joesilber/raft-design/illustrations/chamfered equilateral triangle coords.png

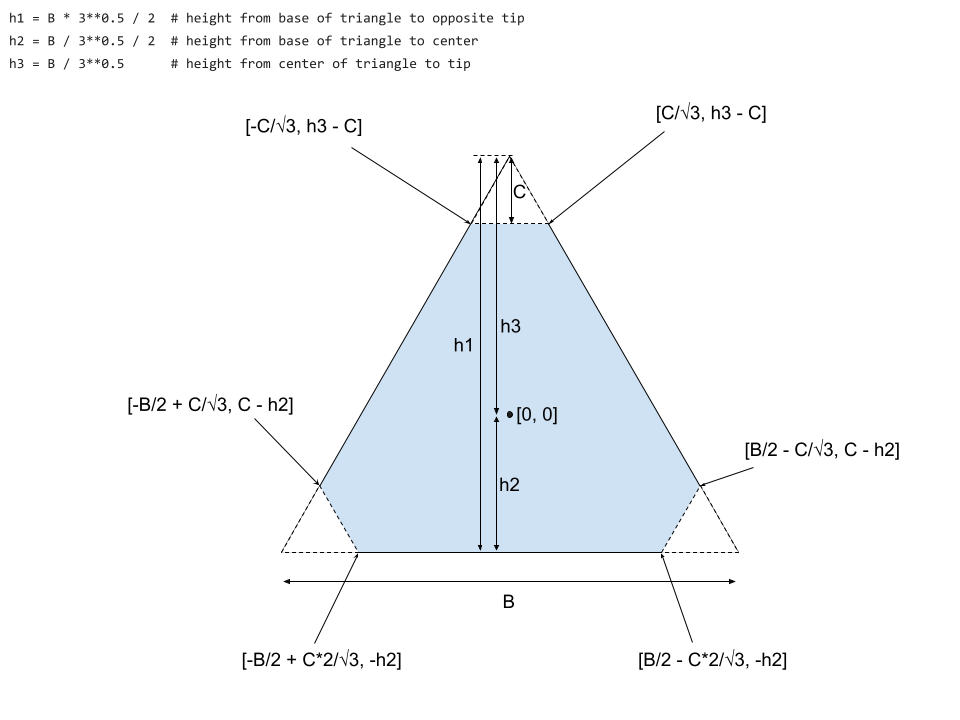
illustrations/chamfered equilateral triangle coords.png
