joesilber/raft-design/illustrations/echo22_chief_ray_deviation.png

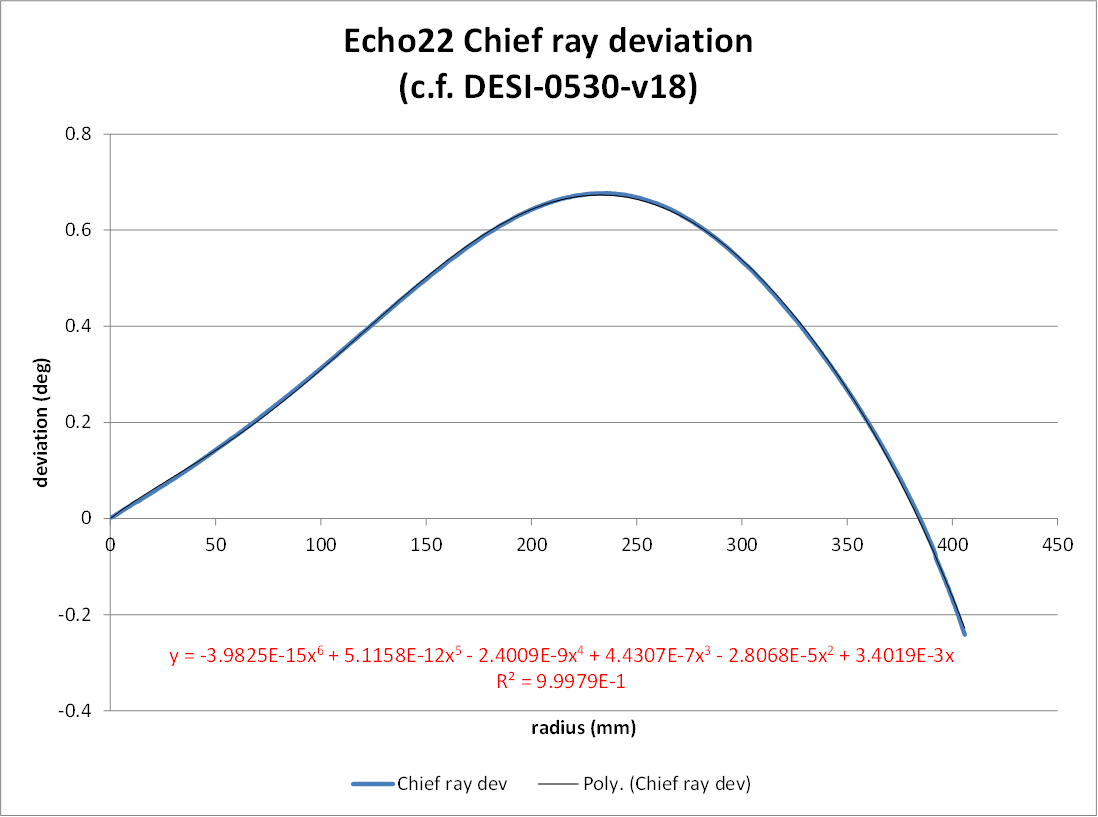
illustrations/echo22_chief_ray_deviation.png
