joesilber/raft-design/MM_Raft_Hole_Positive_2022_06_10.STEP

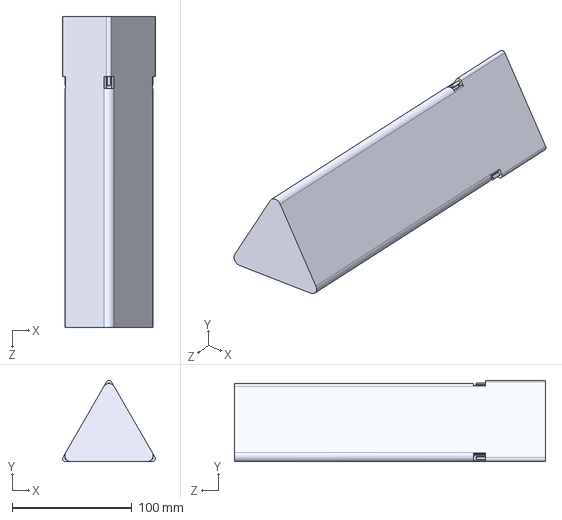
[picture p4: CAD file, 2022-06-10]
MM_Raft_Hole_Positive_2022_06_10.STEP
77.5 x 67.8 x 259.7 mm
