joesilber/raft-design/illustrations/chamfered equilateral triangle coords.pdf

## [C/√3, h3 - C] [-C/√3, h3 - C]

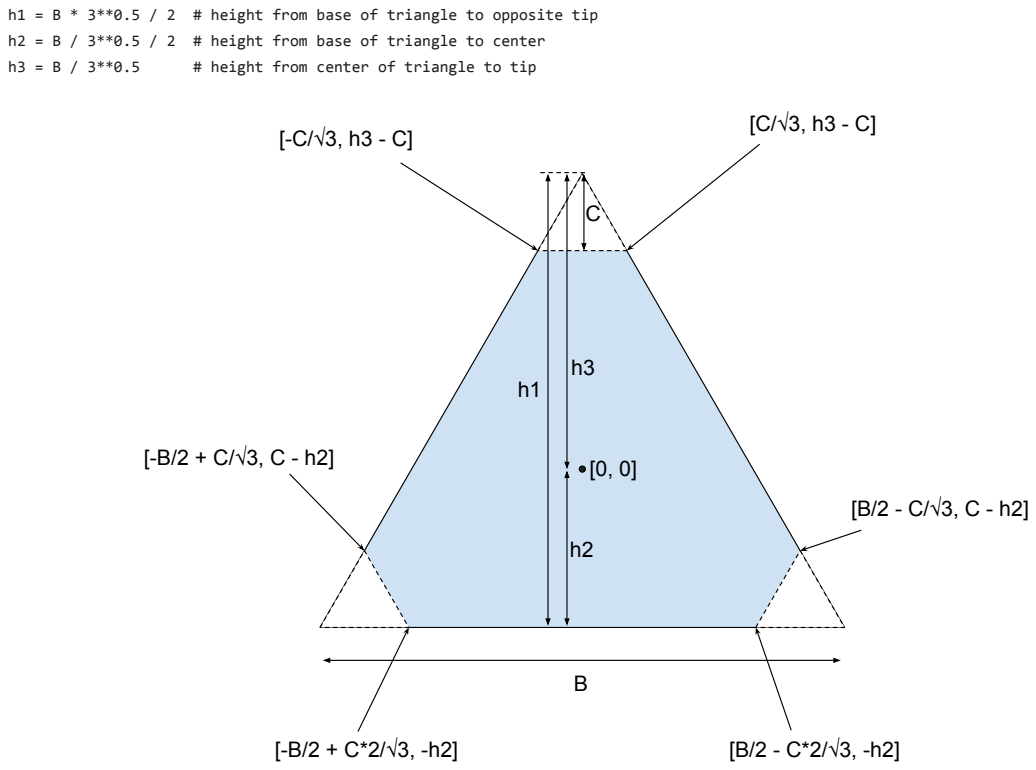
[picture p5: page 1]
# height from center of triangle to tip

h1 = B * 3**0.5 / 2 # height from base of triangle to opposite tip
h2 = B / 3**0.5 / 2 # height from base of triangle to center
