joesilber/raft-design/illustrations/raft assembly chamfer details 2022-06-03.png

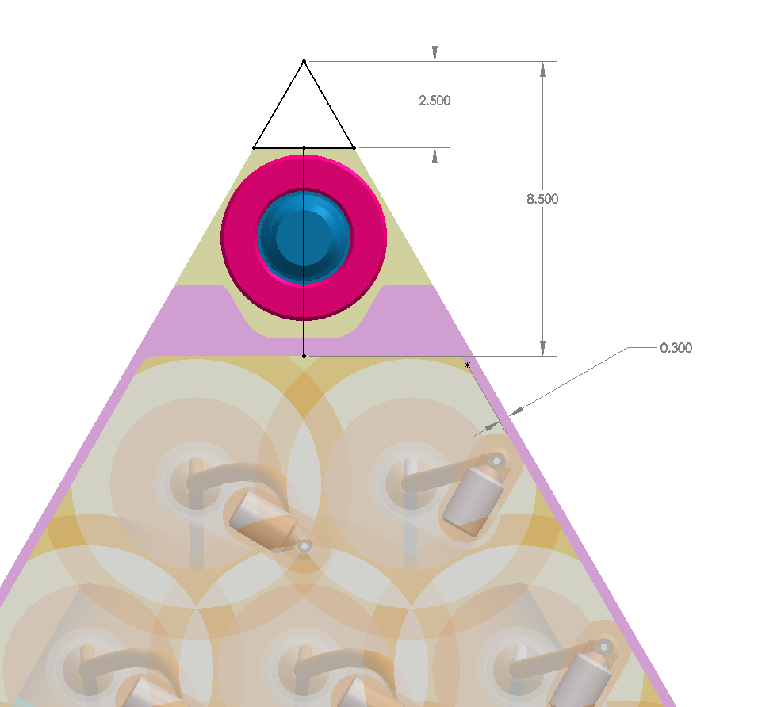
illustrations/raft assembly chamfer details 2022-06-03.png
