joesilber/raft-design/(commit log)

2022-05-20 Create MM Raft Assembly - simplified - 2022-05-19.STEP
    [MM Raft Assembly - simplified - 2022-05-19.STEP]
2022-05-29 NUT = -(NORM + CRD)
2022-05-29 10000 interpolation sample points looks reasonably accurate
2022-05-29 replace weirdo hard-to-read txt file with proper csv
    [MM1536_cfg1_2021-09-10.csv]
2022-05-30 add raft.z property and some other cleanup of similar props
2022-05-30 make return in collision case a 2-tuple
2022-05-30 remove temp debug hack for checking poly collision case
2022-05-31 more conservative but reliable convex case gap prediction
2022-06-02 add some timers and gap stats printing
2022-06-02 minor print fmt update
2022-06-02 fix some iteration display printing
2022-06-02 convert print() to logger
2022-06-03 rename to remove underscores
    [MM1536-cfg1-20210910.csv]
2022-06-03 log string fixes for non-iterative case
2022-06-03 Create raft assembly chamfer details 2022-06-03.png
2022-06-04 fix print of efficiency value
2022-06-09 comment out an excessive limit radius case
2022-06-09 fix surf area calc for wedge case
2022-06-10 rename better for freecad
    [MM_Raft_Assembly_simplified_2022_05_19.STEP]
2022-08-18 cleaner but still too simplistic front gap estimation for convex case
2022-11-29 clarified shape of polygon props
2022-11-29 pass robot pitch to raft, and implemented raft.robot_centers (but with dummy z offset -- still need to replace placeholder value with actual best-fit sphere shift)
2022-12-07 brought in area grid evaluation code for no-shield case from DESI-5513 script
2022-12-07 some debugging of area coverage plot for no-shield case
2022-12-07 add no-shield case for baseline desi2
2022-12-07 no-shield case for baseline raft now working
2022-12-08 add elaboration on neighbor selection for trilllium case
2022-12-08 fixed instr_profile for no shield case
2022-12-16 fix np power
2023-01-30 get_grid_idx fix for trilliums case
2023-01-30 trilliums without hex tiling case
2023-02-06 fix logging bugs for megamapper case, and add to-do notes for defocus/blur loss functions
2023-03-20 add ref docs from DESI
    [DESI-0530-v18 (Focal Plane Layout).xlsx, DESI-347-v17_Throughput-Noise-SNR-Calcs.xlsx]
2024-02-15 cleaner handling of Z(r) and CRD(r) file input data
    [Jelinsky6m-CRD-20240215.csv, MM1536-cfg1-20210910.csv]
2024-02-15 finished jelinsky 6m case input
2024-02-15 add xlsx docs received from Jelinsky
    [2024-04-13 6mfocalplane (from Jelinsky).xlsx, 2024-04-14 6msphericalfocalplane (from Jelinsky).xlsx]
2024-02-15 add jelinsky6m case
2024-02-15 Update MM1536-cfg1-20210910.csv
    remove weird ,,,, made by excel
    [MM1536-cfg1-20210910.csv]
2024-02-15 add .0 to 0
    [Jelinsky6m-CRD-20240215.csv]
2024-02-15 fixed encoding
    [Jelinsky6m-CRD-20240215.csv]
